chxrro/hackutd-26/hub/haptic_hub/sim/scenarios.py

"""The scenario library. Each scenario builds a fresh world, optionally injects
faults, and lists checks on what the belt does.

Geometry notes (default CameraModel, 60 deg horizontal FOV, 5 sectors): sector
boundaries sit at about -30, -19, -6.6, +6.6, +19, +30 deg from the camera axis.
With the default thresholds a static obstacle starts to buzz below ~2.27 m
z-depth (depth risk 0 at 2.5 m, deadband 0.12), and a tracked person starts to
buzz once the box-growth TTC drops under 3 s.

Tags:
  core   pipeline behavior that should hold today (gates the run)
  fault  failure injection: stale camera, disconnects, crashes, lost belt writes
  probe  known or suspected perception limitations; expected to fail today and
         reported as findings, not as regressions
"""

from __future__ import annotations

import math
from collections.abc import Callable
from dataclasses import dataclass, field

from haptic_hub.config import HubConfig
from haptic_hub.sim import checks as c
from haptic_hub.sim.oracle import OracleNoise
from haptic_hub.sim.render import CameraModel
from haptic_hub.sim.world import Box, Walker, World, const, person, pole, ramp, steps, wall

ALL = (0, 1, 2, 3, 4)


@dataclass(frozen=True)
class Fault:
    kind: str  # camera_freeze | phone_disconnect | garbage | latency | perception_crash |
    #            perception_stall | belt_drop | belt_unapplied | belt_disconnect | user_stop | user_stop_unpaired
    start: float
    end: float
    value: float = 0.0


@dataclass
class Scenario:
    name: str
    description: str
    duration: float
    build: Callable[[], World]
    checks: list[c.Check]
    faults: list[Fault] = field(default_factory=list)
    tags: frozenset[str] = frozenset({"core"})
    camera: CameraModel = field(default_factory=CameraModel)
    noise: OracleNoise | None = None
    configure: Callable[[HubConfig], None] | None = None
    fps: float = 15.0
    danger_m: float = 1.2  # for the informational coverage metric
    quiet_m: float = 3.0


def _pole_ahead(x: float = 0.0, y: float = 1.2) -> Callable[[], World]:
    return lambda: World([pole(x, y, radius=0.05)], Walker())


def _wall_ahead(walk_s: float, speed: float = 0.8, face_y: float = 4.525, **walker) -> Callable[[], World]:
    def build() -> World:
        return World([wall(-6, face_y + 0.075, 6, face_y + 0.075)], Walker(speed=steps((0, speed), (walk_s, 0)), **walker))

    return build


def _approaching_person(speed: float = 1.5, start_y: float = 9.0, stop_y: float = 1.9, x: float = 0.0,
                        confidence: float = 0.9, extra=()) -> Callable[[], World]:  # fmt: skip
    """Standing wearer; a person walks straight at them and stops at stop_y."""
    stop_t = (start_y - stop_y) / speed

    def build() -> World:
        p = person(x, start_y, velocity=(0, -speed), moving=steps((0, 1), (stop_t, 0)), confidence=confidence)
        return World([*extra, p], Walker())

    return build


def _careful_walker(threshold: int = 150, reaction_s: float = 0.4):
    """A crude model of a person using the belt: waits while it plays the fault
    pattern (including at start-up), and stops for good reaction_s after any of
    the three middle motors reaches `threshold`."""
    state: dict[str, float | None] = {"felt": None}

    def react(levels: tuple[int, ...], fault: bool, t: float) -> float:
        if fault:
            return 0.0
        if state["felt"] is None and max(levels[1:4]) >= threshold:
            state["felt"] = t
        felt = state["felt"]
        return 0.0 if felt is not None and t - felt >= reaction_s else 1.0

    return react


def _scenarios() -> list[Scenario]:
    deg = math.radians
    s: list[Scenario] = []

    # ------------------------------------------------------------ core behavior
    s.append(Scenario(
        "approach_wall", "Walk at 0.8 m/s toward a wide wall and stop ~0.9 m short.", 6.5,
        _wall_ahead(walk_s=4.5),
        [c.motors_off(ALL, 0.8, 2.3), c.motors_on(ALL, 3.4, 6.5), c.level_rises(2, (3.0, 3.6), (5.0, 6.5)),
         c.no_fault(0.8, 6.5), c.no_collision(), c.status_reports(1.0, 6.5, healthy=True)],
    ))  # fmt: skip
    s.append(Scenario(
        "pole_left", "Standing; a thin pole 1.2 m ahead, 0.55 m to the left.", 4.0,
        _pole_ahead(-0.55), [c.motors_on(0, 1.0, 4.0), c.motors_off((1, 2, 3, 4), 1.0, 4.0), c.no_fault(0.8, 4.0)],
    ))  # fmt: skip
    s.append(Scenario(
        "pole_right", "Standing; a thin pole 1.2 m ahead, 0.55 m to the right.", 4.0,
        _pole_ahead(0.55), [c.motors_on(4, 1.0, 4.0), c.motors_off((0, 1, 2, 3), 1.0, 4.0), c.no_fault(0.8, 4.0)],
    ))  # fmt: skip
    s.append(Scenario(
        "two_poles", "Poles left and right with a clear gap in the middle.", 4.0,
        lambda: World([pole(-0.55, 1.2, radius=0.05), pole(0.55, 1.2, radius=0.05)], Walker()),
        [c.motors_on((0, 4), 1.0, 4.0), c.motors_off((1, 2, 3), 1.0, 4.0)],
    ))  # fmt: skip
    s.append(Scenario(
        "pole_center", "Standing; a thin pole 1.2 m straight ahead.", 4.0,
        _pole_ahead(0.0), [c.motors_on(2, 1.0, 4.0), c.motors_off((0, 1, 3, 4), 1.0, 4.0), c.no_fault(0.8, 4.0)],
    ))  # fmt: skip
    s.append(Scenario(
        "three_obstacles", "Pole left at 1.2 m, wall segment center-right at 1.6 m, nothing far right.", 4.0,
        lambda: World([pole(-0.55, 1.2, radius=0.05), wall(-0.05, 1.6, 0.35, 1.6, thickness=0.1)], Walker()),
        [c.motors_on((0, 2, 3), 1.0, 4.0), c.motors_off((1, 4), 1.0, 4.0), c.strongest(0, 1.0, 4.0)],
    ))  # fmt: skip
    s.append(Scenario(
        "person_vs_pole", "Standing; a still pole 3 m ahead-right (outside the depth range) and a person "
        "walking in at 1.5 m/s ahead-left who stops 2.6 m away. Only the approaching person should buzz, "
        "and only while approaching.", 6.0,
        _approaching_person(start_y=7.5, stop_y=2.6, x=-0.5, extra=(pole(0.5, 3.0, radius=0.05),)),
        [c.motors_off(ALL, 1.0, 2.2), c.motors_on(1, 2.85, 3.35, min_frac=0.7), c.motors_off((3, 4), 1.0, 6.0),
         c.motors_off(ALL, 4.6, 6.0), c.no_fault(0.8, 6.0)],
    ))  # fmt: skip
    s.append(Scenario(
        "camera_motion", "Standing; a still person 4 m ahead and a pole 3.5 m ahead-right. The head sways "
        "+-10 deg (yaw, 1.2 Hz) and bobs +-5 deg (pitch, 2.4 Hz). Nothing is close or approaching.", 5.0,
        lambda: World([person(0, 4.0), pole(0.6, 3.5)],
                      Walker(head_yaw=lambda t: deg(10) * math.sin(2 * math.pi * 1.2 * t),
                             pitch=lambda t: deg(5) * math.sin(2 * math.pi * 2.4 * t))),
        [c.motors_off(ALL, 1.0, 5.0), c.no_fault(0.8, 5.0)],
    ))  # fmt: skip
    s.append(Scenario(
        "walking_sway", "Walk 0.8 m/s toward a wall with +-8 deg head sway; the wall must still alert.", 6.5,
        _wall_ahead(walk_s=4.5, head_yaw=lambda t: deg(8) * math.sin(2 * math.pi * 1.0 * t)),
        [c.motors_on((1, 2, 3), 4.0, 6.5), c.no_fault(0.8, 6.5), c.no_collision()],
    ))  # fmt: skip
    s.append(Scenario(
        "low_confidence_person", "person_approaching, but the detector only scores the person 0.2 (below "
        "detector_conf 0.35, e.g. poor light). Depth must still alert once the person is in range.", 6.0,
        _approaching_person(confidence=0.2),
        [c.motors_off(ALL, 1.0, 4.1), c.motors_on(2, 4.6, 6.0), c.no_fault(0.8, 6.0)],
    ))  # fmt: skip
    s.append(Scenario(
        "head_turn", "Pole straight ahead of the torso; at 2.5 s the wearer looks 25 deg left. "
        "The alert follows the head (documented behavior), so it moves to the right motor.", 5.0,
        lambda: World([pole(0, 1.5, radius=0.05)], Walker(head_yaw=ramp(2.5, 2.8, 0.0, deg(-25)))),
        [c.motors_on(2, 1.0, 2.4), c.motors_off((0, 1, 3, 4), 1.0, 2.4),
         c.motors_on(4, 3.2, 5.0), c.motors_off((0, 1, 2), 3.2, 5.0)],
    ))  # fmt: skip
    s.append(Scenario(
        "person_approaching", "Standing; a person walks at the wearer at 1.5 m/s from 9 m and stops 1.9 m "
        "away. Box-growth TTC must alert before depth range (~2.27 m, from t~4.3 s).", 6.0,
        _approaching_person(),
        [c.motors_off(ALL, 1.0, 3.2), c.motors_on(2, 3.85, 4.3, min_frac=0.8), c.motors_on(2, 4.4, 6.0),
         c.no_fault(0.8, 6.0)],
        danger_m=1.8,
    ))  # fmt: skip
    s.append(Scenario(
        "clear_path", "Walk 1 m/s down an open path lined with poles 3.5 m to each side.", 5.0,
        lambda: World([pole(x, y) for y in range(2, 20, 3) for x in (-3.5, 3.5)] + [wall(-10, 30, 10, 30)],
                      Walker(speed=const(1.0))),
        [c.motors_off(ALL, 1.0, 5.0), c.no_fault(0.8, 5.0), c.no_collision()],
    ))  # fmt: skip
    s.append(Scenario(
        "careful_walker", "Closed loop: the wearer walks at 1.2 m/s toward a wall and stops 0.4 s after a middle "
        "motor reaches level 150.", 7.0,
        lambda: World([wall(-6, 6.6, 6, 6.6)], Walker(speed=const(1.2), react=_careful_walker())),
        [c.no_collision(), c.clearance_at_end(0.3, 1.6), c.motors_on(2, 6.0, 7.0)],
    ))  # fmt: skip
    s.append(Scenario(
        "noisy_depth", "approach_wall with a depth model that reads 15% far and has 10% per-pixel noise.", 6.5,
        _wall_ahead(walk_s=4.5), [c.motors_on(ALL, 4.5, 6.5), c.no_fault(0.8, 6.5), c.no_collision()],
        noise=OracleNoise(depth_scale=1.15, depth_sigma=0.10),
    ))  # fmt: skip
    s.append(Scenario(
        "flaky_detector", "person_approaching with a detector that misses the person on 30% of frames.", 6.0,
        _approaching_person(),
        [c.motors_off(ALL, 1.0, 3.2), c.motors_on(2, 4.4, 6.0, min_frac=0.85), c.no_fault(0.8, 6.0)],
        noise=OracleNoise(miss_prob=0.3),
    ))  # fmt: skip

    # ------------------------------------------------------------ failure injection
    fault = frozenset({"fault"})
    stale = HubConfig().safety.frame_stale_s
    belt_period = 1 / HubConfig().haptics.send_hz
    s.append(Scenario(
        "camera_freeze", "Pole ahead; the glasses stream stalls for 2 s (phone still connected).", 6.5,
        _pole_ahead(),
        [c.motors_on(2, 1.0, 2.4), c.fault_within(2.5, stale + belt_period + 0.15), c.fault_during(3.7, 4.5),
         c.recovers_within(4.5, 0.6), c.motors_on(2, 5.3, 6.5), c.status_reports(3.8, 4.5, healthy=False)],
        [Fault("camera_freeze", 2.5, 4.5)], fault,
    ))  # fmt: skip
    s.append(Scenario(
        "phone_disconnect", "Pole ahead; the phone's WebSocket drops for 2 s, then reconnects.", 6.5,
        _pole_ahead(),
        [c.motors_on(2, 1.0, 2.4), c.fault_within(2.5, stale + belt_period + 0.15), c.fault_during(3.7, 4.5),
         c.recovers_within(4.5, 0.8), c.motors_on(2, 5.5, 6.5), c.counter("phone_connects", lambda n: n >= 2, ">= 2")],
        [Fault("phone_disconnect", 2.5, 4.5)], fault,
    ))  # fmt: skip
    s.append(Scenario(
        "perception_crash", "Pole ahead; the model raises on every frame for 1.5 s.", 5.5,
        _pole_ahead(),
        [c.motors_on(2, 1.0, 2.4), c.fault_within(2.5, 0.3), c.fault_during(2.9, 4.0), c.recovers_within(4.0, 0.6),
         c.motors_on(2, 4.8, 5.5), c.status_reports(2.9, 4.0, healthy=False)],
        [Fault("perception_crash", 2.5, 4.0)], fault,
    ))  # fmt: skip
    result_stale = HubConfig().safety.result_stale_s
    s.append(Scenario(
        "perception_stall", "Pole ahead; one inference hangs for 2.5 s (frames keep arriving).", 6.5,
        _pole_ahead(),
        [c.motors_on(2, 1.0, 2.4), c.fault_within(2.5, result_stale + 0.3), c.recovers_within(5.0, 0.6),
         c.motors_on(2, 5.8, 6.5)],
        [Fault("perception_stall", 2.5, 2.6, value=2.5)], fault,
    ))  # fmt: skip
    # Lost writes: the hub writes with response, so it notices within one command
    # TTL (+ a belt-loop tick, + one status period for the phone to hear it), sends
    # the fault pattern, and after BleBelt.WRITE_TIMEOUT_S without an answer drops
    # the connection and reconnects.
    ttl_s = HubConfig().haptics.ttl_ms / 1000
    status_period = 1 / HubConfig().status_hz
    s.append(Scenario(
        "belt_writes_lost", "Pole ahead; BLE writes are silently lost for 1 s (link stays up). The firmware TTL "
        "plays the fault pattern; the hub must report 'belt not acknowledging', reconnect, and recover.", 5.5,
        _pole_ahead(),
        [c.motors_on(2, 1.0, 2.4), c.fault_within(2.5, ttl_s + belt_period + 0.05), c.fault_during(2.9, 3.5),
         c.status_unhealthy_within(2.5, ttl_s + belt_period + status_period + 0.15, "belt not acknowledging"),
         c.status_reports(2.5 + ttl_s + belt_period + status_period + 0.15, 3.5, healthy=False, min_frac=1.0),
         c.recovers_within(3.5, 0.6), c.motors_on(2, 4.3, 5.5), c.status_reports(4.5, 5.5, healthy=True, min_frac=1.0),
         c.counter("belt_reconnects", lambda n: n >= 1, ">= 1")],
        [Fault("belt_drop", 2.5, 3.5)], fault,
    ))  # fmt: skip
    # Writes acknowledged but never applied: the write-ack check can't see this.
    # The firmware's TTL lapses, its status notification (sent on the mode change)
    # says "expired", and the hub reports it within one TTL + notify latency + a
    # belt-loop tick + one status period. No reconnect: the link itself is fine.
    s.append(Scenario(
        "belt_not_applying", "Pole ahead; for 1 s the belt's BLE stack acknowledges every write but the firmware "
        "never applies them (event queue full / main loop stalled). The firmware TTL plays the fault pattern; "
        "only its status notifications show it. The hub must report 'belt TTL expired' and recover.", 5.5,
        _pole_ahead(),
        [c.motors_on(2, 1.0, 2.4), c.fault_within(2.5, ttl_s + belt_period + 0.05), c.fault_during(2.9, 3.5),
         c.status_unhealthy_within(2.5, ttl_s + belt_period + status_period + 0.15, "belt TTL expired"),
         c.status_reports(2.5 + ttl_s + belt_period + status_period + 0.15, 3.5, healthy=False, min_frac=1.0),
         c.recovers_within(3.5, 0.6), c.motors_on(2, 4.3, 5.5), c.status_reports(4.5, 5.5, healthy=True, min_frac=1.0),
         c.counter("belt_writes_unapplied", lambda n: n >= 10, ">= 10"),
         c.counter("belt_reconnects", lambda n: n == 0, "== 0")],
        [Fault("belt_unapplied", 2.5, 3.5)], fault,
    ))  # fmt: skip
    s.append(Scenario(
        "belt_disconnect", "Pole ahead; the BLE link drops for 1 s; the hub reconnects.", 5.5,
        _pole_ahead(),
        [c.motors_on(2, 1.0, 2.4), c.fault_within(2.5, 0.05), c.fault_during(2.6, 3.5),
         c.status_unhealthy_within(2.5, belt_period + status_period + 0.1),
         c.status_reports(2.5 + belt_period + status_period + 0.1, 3.5, healthy=False, min_frac=1.0),
         c.recovers_within(3.5, 0.8), c.motors_on(2, 4.5, 5.5), c.status_reports(4.7, 5.5, healthy=True, min_frac=1.0)],
        [Fault("belt_disconnect", 2.5, 3.5)], fault,
    ))  # fmt: skip
    # The wearer's Stop vs. a phone that just goes away (docs/protocol.md "end_session").
    s.append(Scenario(
        "user_stop", "Pole ahead; at 2.5 s the wearer presses Stop (paired phone: end_session, then the camera "
        "stops). The belt plays the session-ended cue and stays quiet, also while the phone's Wi-Fi drops "
        "(4.0-4.8 s). Start at 5.5 s brings alerts back.", 8.0,
        _pole_ahead(),
        [c.motors_on(2, 1.0, 2.4), c.no_fault(2.5, 5.5), c.pulses((1, 3), 2.6, 4.3, count=3),
         c.motors_off(ALL, 4.3, 5.5), c.status_reason(2.8, 5.4, "stopped by wearer"),
         c.hub_reason(2.8, 5.4, "stopped by wearer"), c.motors_on(2, 6.6, 8.0), c.status_reports(7.0, 8.0, healthy=True),
         c.counter("end_session_ok", lambda n: n == 1, "== 1"), c.counter("phone_connects", lambda n: n >= 2, ">= 2")],
        [Fault("user_stop", 2.5, 5.5), Fault("phone_disconnect", 4.0, 4.8)], fault,
    ))  # fmt: skip
    s.append(Scenario(
        "phone_vanishes", "Pole ahead; at 2.5 s the phone vanishes (WebSocket gone, no end_session) and never "
        "comes back. The hub must play the fault pattern for as long as it runs.", 5.5,
        _pole_ahead(),
        [c.motors_on(2, 1.0, 2.4), c.fault_within(2.5, stale + belt_period + 0.15), c.fault_during(3.7, 5.5),
         c.hub_reason(3.7, 5.5, "no camera frames"), c.counter("phone_connects", lambda n: n == 1, "== 1")],
        [Fault("phone_disconnect", 2.5, 99.0)], fault,
    ))  # fmt: skip
    s.append(Scenario(
        "user_stop_unpaired", "Pole ahead; a phone without the control code presses Stop at 2.5 s. end_session "
        "is refused (not paired), so the hub treats it like a lost phone: fault pattern.", 5.0,
        _pole_ahead(),
        [c.motors_on(2, 1.0, 2.4), c.fault_within(2.5, stale + belt_period + 0.15), c.fault_during(3.7, 5.0),
         c.hub_reason(3.7, 5.0, "no camera frames"), c.counter("end_session_refused", lambda n: n == 1, "== 1")],
        [Fault("user_stop_unpaired", 2.5, 99.0)], fault,
    ))  # fmt: skip
    s.append(Scenario(
        "garbage_frames", "Pole ahead; the phone interleaves malformed packets and broken JPEGs.", 5.0,
        _pole_ahead(),
        [c.no_fault(0.8, 5.0), c.motors_on(2, 1.0, 5.0), c.counter("bad_messages", lambda n: n >= 10, ">= 10")],
        [Fault("garbage", 0.5, 5.0, value=2)], fault,
    ))  # fmt: skip
    s.append(Scenario(
        "network_latency", "approach_wall with 200 +-100 ms phone->hub latency.", 6.5,
        _wall_ahead(walk_s=4.5),
        [c.no_fault(0.8, 6.5), c.motors_on(ALL, 4.2, 6.5), c.no_collision()],
        [Fault("latency", 0.0, 6.5, value=0.2)], fault,
    ))  # fmt: skip

    # ------------------------------------------------------------ probes (limitations)
    probe = frozenset({"probe"})
    s.append(Scenario(
        "probe_indoor_ceiling", "Standing in the middle of an 8 x 12 m room with a 2.6 m ceiling; nearest wall "
        "is 6 m ahead. Should be quiet.", 4.0,
        lambda: World([wall(-4, 6, 4, 6), wall(-4, -6, 4, -6), wall(-4, -6, -4, 6), wall(4, -6, 4, 6)],
                      Walker(), ceiling=2.6),
        [c.motors_off(ALL, 1.0, 4.0)], tags=probe,
    ))  # fmt: skip
    s.append(Scenario(
        "probe_looking_down", "Open ground, nothing within 10 m, head pitched 20 deg down (a normal walking "
        "posture). Should be quiet.", 4.0,
        lambda: World([wall(-10, 15, 10, 15)], Walker(pitch=const(deg(20)))),
        [c.motors_off(ALL, 1.0, 4.0)], tags=probe,
    ))  # fmt: skip
    s.append(Scenario(
        "probe_low_obstacle", "Walk at 0.8 m/s toward a 0.45 m tall box (bench / bin height) 3 m ahead.", 5.5,
        lambda: World([Box(0.45, (40, 140, 200), center=(0, 3.3), size=(1.2, 0.6), name="low box")],
                      Walker(speed=const(0.8))),
        [c.motors_on(2, 2.6, 3.4, min_frac=0.5), c.no_collision()], tags=probe,
    ))  # fmt: skip
    s.append(Scenario(
        "probe_low_confidence_warning", "low_confidence_person, asking for the early (TTC) warning that a "
        "confident detection gives at 3.85-4.3 s. Low-confidence boxes are dropped, so nothing marks the "
        "person as uncertain: is the wearer told anything before depth range?", 6.0,
        _approaching_person(confidence=0.2),
        [c.motors_on(2, 3.85, 4.3, min_frac=0.5)], tags=probe,
    ))  # fmt: skip
    s.append(Scenario(
        "probe_ttc_lag", "Person walks in at 1.2 m/s from 8 m. Ask for an alert by the time the true TTC "
        "(center distance / speed) is 2.5 s (t~4.2 s), i.e. that the box-growth TTC isn't late.", 6.0,
        _approaching_person(speed=1.2, start_y=8.0),
        [c.motors_on(2, 4.2, 4.5, min_frac=0.9)], tags=probe,
    ))  # fmt: skip
    s.append(Scenario(
        "probe_jittery_boxes", "Standing; a person walks in at 1.5 m/s from 9 m, detector boxes jitter 4 px "
        "(sigma, full-res). Should stay quiet while the person is far (> 4.5 m) and not yet near TTC 3 s.", 6.0,
        _approaching_person(), [c.motors_off(ALL, 1.0, 3.0)], tags=probe,
        noise=OracleNoise(box_jitter_px=4.0),
    ))  # fmt: skip
    return s


SCENARIOS: dict[str, Scenario] = {sc.name: sc for sc in _scenarios()}


def select(names: list[str] | None, tags: set[str] | None = None) -> list[Scenario]:
    if names:
        unknown = [n for n in names if n not in SCENARIOS]
        if unknown:
            raise KeyError(f"unknown scenario(s) {unknown}; known: {sorted(SCENARIOS)}")
        return [SCENARIOS[n] for n in names]
    return [sc for sc in SCENARIOS.values() if tags is None or sc.tags & tags]
