chxrro/hackutd-26/(commit log)

2026-11-07 docs: record HackUTD project context and open decisions
    Document project context, goals, and initial milestones for HackUTD 2026 accessibility prototype.
2026-11-07 docs: add agent guide for HackUTD prototype
    Added a comprehensive agent guide outlining project context, working rules, safety design, and validation processes for the HackUTD 2026 accessibility project.
2026-11-07 docs: link project context from README
    Added project context and description for accessibility prototype.
2026-11-07 docs: add wire protocol shared by esp32, hub and meta
2026-11-07 esp32: BLE belt firmware with TTL failsafe, fault pattern and serial console
    [ble_link.cpp, ble_link.h, config.h, main.cpp, motors.cpp, motors.h, test_main.cpp]
2026-11-07 hub: video feed in, depth + YOLO collision perception, haptic commands out over BLE
    [__main__.py, app.py, cli.py, config.py]
2026-11-07 meta: iPhone app that streams the Meta glasses camera to the hub
2026-11-08 Add standalone Ray-Ban Camera Bridge diagnostic
2026-11-08 hub: person vs object labels, local and Nemotron cloud backend
    Every tracked box gets a person/object label (--classifier local|nim).
    local reuses YOLO's COCO class. nim asks Nemotron 3 Nano Omni behind any
    OpenAI-compatible endpoint (vLLM on Brev, or build.nvidia.com) in the
    background at <=2 req/s, cached per track ID; YOLO stays the fast path.
    If boxes wait 3 s without a cloud reply, perception raises
    ClassifierUnavailable and the belt plays the fault pattern.
    Adds nim-bench to measure round trips. No new dependencies; protocol,
    belt behaviour and existing perception code unchanged.
2026-11-08 hub: fault when the perception result is too old
    The safety monitor only checked when the last result finished, not how old
    its frame was. A slow model (e.g. 1.4 s per frame) delivered results just
    under result_stale_s, so the belt played LEVELS or OFF from data up to 2.8 s
    old while reporting healthy, and an old result was replayed for a moment
    after a short frame gap.
    SafetyMonitor.perception_ok now takes the frame's receive time (hub
    monotonic clock) and check() faults when it is older than the new
    SafetyConfig.result_max_age_s (1.0 s, unvalidated starting value).
    [app.py, config.py, safety.py]
2026-11-08 hub: cloud classifier outage falls back to local labels, not the fault pattern
    A cloud outage (timeout, 429, network) made ClassifiedPerception raise
    ClassifierUnavailable, which discarded the whole result: the belt played the
    fault pattern instead of real depth/TTC alerts, although labels don't drive
    the belt. Now every box keeps its local label and debug["classifier"] carries
    stale=True and the reason, which the --show window prints as ERR.
    ClassifierUnavailable stays defined for when labels drive the belt; then an
    unavailable classifier has to become a fault again. Decision recorded in
    docs/project-context.md.
2026-11-08 hub: drop half-open BLE connections and keep reconnecting
    If connect() succeeded but reading the info characteristic failed, the
    client was never disconnected. The belt firmware stops advertising while
    connected, so the hub could never find it again; the belt heard nothing and
    went from the fault pattern to silence after 30 s. A short info payload
    raised ValueError, which killed the belt task and the hub.
    Setup failures now disconnect the client (5 s timeout), a short info payload
    is a BleakError, and run() retries after any exception. Reconnect delays are
    class attributes so tests can shorten them. Tested with a fake bleak client
    only.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
2026-11-08 hub: open-vocabulary detector option (--detector openvocab)
    Adds OpenVocabTracker (YOLOE, text prompts + ByteTrack) with the same
    track() interface as ObjectTracker, selected via PerceptionConfig.detector
    or --detector/--prompts. Labels map person-like prompts to "person" so
    classify.py keeps working. Default stays "yolo". vision.py/models.py
    unchanged. New vision dependency: clip (ultralytics fork, pinned commit).
2026-11-08 hub: opt-in session recording/replay and per-stage latency
    - --record wraps any frame source; JPEG + frames.jsonl per numbered session
    under hub/recordings/ (git-ignored), bounded by time/frames, written off the
    event loop, drops recorded copies instead of blocking.
    - --source replay:DIR replays a session at original timing, labelled replay.
    - Per-stage hub latency (queue, infer, to belt, hub total, drops, fps) logged
    every 5 s and shown in --show; phone status JSON unchanged.
2026-11-08 hub: add optional optical-flow approach/crossing risk (--motion flow)
    Adapts Nathan's optical-flow motion check from PR #3 (scripts/visual_motion.py)
    as a hub perception wrapper, off by default. For each ByteTrack box it fits a
    similarity transform to LK flow against a ~0.15 s older frame:
    - approach: TTC ~= dt / ln(scale), through the existing 1-3 s risk curve
    - crossing: box motion minus background motion (head turns cancel); a near box
    whose 1 s projection sweeps into the middle band raises the swept sectors to 0.5
    Flow only raises sector risk (max-merge); missing texture/reference adds
    nothing; failures raise so the belt plays the fault pattern. All thresholds
    live in FlowConfig and a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
    [cli.py, config.py, flow.py]
2026-11-08 meta: device-ready Info.plist, glasses app update button, test-day checklist
    - Info.plist: add external-accessory background mode and
    UISupportedExternalAccessoryProtocols (com.meta.ar.wearable), matching
    ios/Info.plist that ran on the iPhone 17; opt out of SDK crash reporting.
    - GlassesController/ContentView: "Update glasses app in Meta AI" button
    (openDATGlassesAppUpdate) for the "app component requires an update" error.
    - Hub section hint mentions hotspot and what a timeout means.
    - README: test-day checklist (build/install, hub, app steps, fault vs
    levels, network fallbacks, safety).
2026-11-08 docs: draft additive phone/dashboard -> hub control messages
    Pairing via a hub-generated control code in hello, control/ack messages
    (pause, resume, belt_test, set classifier/alert_range/record) and optional
    status fields. Frame, belt command and existing status fields unchanged.
2026-11-08 docs: clarify control protocol (get action, pairing scope, pause vs fault)
    Additive edits to the draft Control section, found while implementing the hub
    side:
    - new `get` action: no effect, returns settings, doubles as a pairing check
    - pairing is per connection; re-send hello after reconnect; wrong code unpairs
    - while paused, a real fault replaces "alerts paused" in `reason`; read `paused`
    - belt test status (levels, healthy:false, reason "belt test") and refusals
    - record: hubs without recording refuse true and accept false
    - ack `id` echoed as sent; only compare `error` with "not paired"
    - sectors[i].kind = largest box per direction; all null while faulted
    Frame packet, belt command and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
2026-11-08 docs: navigation guidance research and campus route build plan
    Add docs/navigation-research.md: prior work on haptic belts, heading
    sources, routing options and terms, indoor demo options, and the
    contract impact of belt guidance. Includes the ECSW -> Comets LANding
    campus demo build/test plan.
    Implementation is on hold until obstacle alerts work end to end in
    simulation. The `location` message and guidance status field are
    proposals only; docs/protocol.md is unchanged.
2026-11-08 hub: control layer and localhost operator dashboard
    - control.py: runtime settings (pause, belt_test, alert_range, classifier,
    record stub), pairing code, acks to the requesting client only, status
    additions (paused, settings, sectors[i].kind)
    - glasses.py: route hello/control to the control layer, redact control_code
    from logs, cap websockets logging at INFO so -v can't leak the code
    - app.py: belt loop applies pause/belt test; status gains the new fields
    - viz.py: pure render() shared by --show (pixel-identical) and the dashboard
    - dashboard/: --dashboard on 127.0.0.1:8780, plain HTML/CSS/JS, host and
    origin checks, throttled preview that drops frames instead of queueing
    - cli.py: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
    [app.py, cli.py, control.py, viz.py]
2026-11-08 ios: make Camera Bridge the wearer app: hub streaming, control, VoiceOver
    Overhauls Ethan Hur's Camera Bridge (3e8d956) into the user-facing app for
    the Ray-Ban glasses and the haptic belt. His glasses capture, the glasses-app
    update shortcut and the HTTP viewer path are kept; the viewer moves to
    Setup -> Advanced.
    - Hub transport (docs/protocol.md section 1 + Control): HB frame packets,
    hello with control_code (re-sent on every reconnect), phone_status, status
    and ack. Implements get/pause/resume/belt_test/set; paused is read from the
    paused field, never from reason; belt test and "recording not available"
    handled; only error == "not paired" is compared. HubClient, FramePacket and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
2026-11-08 docs: Camera Bridge setup for the hub, mock glasses and checks
2026-11-08 hub: simulated world with firmware-in-the-loop belt and end-to-end scenarios
    Adds hub/haptic_hub/sim (run with `python -m haptic_hub.sim`):
    - numpy ray-cast world rendering glasses frames (504x896, 15 fps) with exact
    ground-truth depth and boxes;
    - a fake phone that sends HB packets over the real WebSocket server;
    - oracle stand-ins for the depth model and detector, so VisionPerception's
    fusion and TTC code runs unchanged (real models optional);
    - the belt firmware's esp32/lib/belt_core logic compiled for the host and
    driven through the real wire encoding (TTL, fault pattern, link loss);
    - 24 gating scenarios plus limitation probes, checked on what the belt does,
    with invariants that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
2026-11-08 docs: record simulated-world status and probe findings
2026-11-08 hub: sim mirrors --motion flow, reports hub stage latency, fixes invariant race
    - `python -m haptic_hub.sim --motion flow` wraps the oracle in
    FlowMotionPerception, as build_perception does; reports name the chain.
    - Each report includes haptic_hub.latency stage timings for the scenario.
    - The fake phone stamps capture_ms before injected network delay, like meta/.
    - The silence invariant compares belt samples on both sides of the hub
    sample, so a health change at that instant isn't counted as a violation
    (a hub that sends OFF instead of FAULT is still caught).
    [__main__.py, checks.py, phone.py, runner.py]
2026-11-08 docs: record the 2026-11-07/08 integration round in project context
    Decisions (#5 stale-result fault, #9 flow motion, #11 open-vocab opt-in, #14
    Control protocol, #13 navigation on hold, #17 ios/ as the wearer app, single
    integration thread + CI) separated from proposals. Status table updated, with
    per-PR evidence and limits labelled unit tests / simulation / synthetic /
    hardware (nothing merged today was tested on hardware). Adds the synthetic TTC
    baseline with figures taken from the run output, correcting an earlier summary
    (0.38-0.63 s late, 0.33-0.53 s hang-over, early false alert on the far-left
    motor only, not from the bus box). Lists the open owner decisions: MobileCLIP2
    licence, meta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
2026-11-08 cad: parametric belt control-box enclosure (rush print version) (#10)
    Adds cad/belt-enclosure/: OpenSCAD source, build.sh (exports STL/3MF, runs interference checks) and README. Generated STLs are not committed (gitignored; regenerate with build.sh). Not printed or test-fitted; dimensions are photo estimates marked MEASURE.
    Squash-merged so the STLs from the branch's first commit stay out of main's history.
    [belt_enclosure.scad]
2026-11-08 hub: sim firmware build without -Werror (unknown CI compilers must not skip the sim)
    [firmware.py]
2026-11-08 hub: pause and resume play a belt cue instead of going silent
    Pause used to send `off`, so the wearer felt the same silence as "no
    obstacle", and a helper could pause from the dashboard or phone without
    the wearer knowing. A real fault while paused was also sent as `off`
    (only the status showed it).
    - pause: outside-in cue (outer pair, inner pair, centre; 0.6 s), then a
    low pulse on the outer motors every 15 s (--pause-reminder, 0 = off)
    - resume: inside-out cue (0.6 s, reason "resuming alerts"), then normal
    - a camera/perception fault now plays the fault pattern while paused;
    the pause cue replays when the fault or a belt disconnect ends
    - cues are ordinary `levels` commands at the nor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
2026-11-08 docs: optional frame_source on phone_status and status (additive)
    Lets the hub tell real glasses frames from the iOS app's mock glasses and
    test pattern. Missing or unrecognized values mean "unknown", never
    "glasses". Frame format, belt command and existing fields unchanged.
2026-11-08 hub: track the phone's frame_source; label simulated/unknown input
    Stores what each phone connection declares in phone_status.frame_source,
    tags its frames, adds frame_source to the phone's status, logs each change
    once, labels anything but "glasses" SIMULATED/UNKNOWN on the dashboard,
    and writes it to recordings (frames.jsonl per frame, session.json counts).
    Missing or unrecognized values are "unknown". Belt output is unchanged.
    [app.py, record.py, types.py]
2026-11-08 hub: add `haptic-hub bench` hardware-day belt checks; docs: bring-up runbook
    hub/haptic_hub/bench/: connect (address, RSSI, connect time), motor map
    with y/n/r prompts, level ramp, TTL failsafe, fault pattern by command
    and by dropped link, reconnect, and BLE write timing (median/p90 of the
    write call, labelled as not motor latency). Optional --serial reads the
    belt's USB log to time TTL expiry and catch rejected commands/reboots.
    JSON report in hub/bench-reports/ (git-ignored), summary table, exit
    code 0/1/3/130. --belt sim runs the whole flow against SimBelt plus a
    model of the firmware TTL timing. cli.py change is additive (register
    subcommand, pass an exit code through).
    docs/hardware-b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
    [cli.py, flow.py, links.py, report.py, serial_log.py]
2026-11-08 ios: send frame_source (glasses | mock | test_pattern) in phone_status
    BridgeModel derives it from the run's source and the Debug mock-glasses
    switch; HubClient keeps it with the last phone_status and now re-sends that
    before marking a reconnect connected, so no frame overtakes it. Protocol
    tests cover the new phone_status example and wire values.
2026-11-08 hub: bench --belt sim runs against the real belt_core build
    Uses haptic_hub.sim.firmware (from #19) so the simulated TTL, link-lost
    and rejected-command events come from esp32/lib/belt_core, ticked every
    5 ms like main.cpp. Falls back to the Python TTL model, with a warning,
    when no C++ compiler is available.
2026-11-08 hub: report "belt not acknowledging" when BLE writes are lost
    The hub wrote belt commands without response, so silently lost writes left
    status healthy while the belt's TTL played the fault pattern. Commands now go
    out with write-with-response (the firmware already accepts both) through a
    latest-wins writer that never blocks the 15 Hz loop. No acknowledged write for
    longer than the command TTL -> healthy:false, reason "belt not acknowledging",
    and the fault pattern is sent; 3 acks in a row recover; an unanswered write
    (1 s) or 15 errors in a row drop the connection and reconnect.
    Belt link problems ("belt disconnected"/"belt connecting") now also make an
    unpaused hub unhealthy, and end a ru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
    [app.py, checks.py, control.py, firmware.py, runner.py]
2026-11-08 docs: belt write acknowledgement and belt status reasons
2026-11-08 ios: accurate wording for pause, reminder pulses and faults while paused
    Matches the hub's pause semantics (#20) and belt write health (#23):
    - Paused: "Alerts are off; the belt pulses softly every 15 seconds as a
    reminder." No more "the belt is off".
    - A real fault while paused is the headline and announcement, with the
    hub's fault-over-pause priority: "Warning: no camera frames (alerts
    paused)". Recovery while still paused: "Recovered. Still paused."
    - The ~0.6 s "resuming alerts" cue shows "Resuming alerts" and is not
    announced; the next state is announced once. Over 2 s it warns.
    - Belt disconnected/connecting are one kind whether reported in reason
    or the belt field, so a reco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
2026-11-08 docs: belt status characteristic (read + notify) and build id in info
    Shared contract change, additive. New BLE status characteristic
    (ba2928d9-...): firmware mode, last applied command seq and age, motor
    levels, uptime, build id, kMaxDuty; notifies on every mode change and at
    least every 500 ms. The info characteristic appends the build id text.
    Golden vectors for both. Section 2 gains belt status reasons and the
    optional belt_firmware / belt_confirmed status fields.
2026-11-08 esp32: status characteristic, build id, mode log
    - lib/belt_core/belt_status.*: status payload encoder and notify trigger
    (mode change or every 250 ms), host-testable; controller exposes the
    last applied command, link-lost cause and output levels.
    - ble_link: status characteristic (read + notify); info characteristic
    appends the build id text.
    - main: publishes status each loop when due; logs "[belt] mode -> X (seq N)"
    so a hub fault command shows on serial; boot line and `s` show build and
    max duty.
    - scripts/build_id.py: stamps the git commit into a generated header.
    - 6 new native tests (golden vector, modes, notify triggers).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
2026-11-08 hub: use the belt's status notifications for belt health
    - protocol: decode status and info (build id) per docs/protocol.md.
    - belt/confirm: StatusHealth checks the belt's reported mode and applied
    seq against what the hub wrote: "belt TTL expired", "belt playing fault
    pattern", "belt not applying commands", "belt status stale". The write
    ack reason keeps precedence.
    - belt/ble: subscribes when the GATT table has the status characteristic
    with notify; older firmware (or a failed subscription) falls back to
    write acknowledgements only.
    - status JSON: optional belt_firmware (build, mode, max duty, ...) and
    belt_confirmed ("status" | "ack" | null); dashboard shows them.
    - sim: the e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
    [app.py, belt_capi.cpp, firmware.py, protocol.py, runner.py]
2026-11-08 docs: end_session control action for a deliberate Stop
    Protocol (additive): paired-only control action `end_session`, a status
    reason "stopped by wearer", a `stopped` status field, and a session-ended
    belt cue. `phone_status` stream "starting" (or a new frame) ends the stop.
    A phone that goes away without end_session still gets the fault pattern.
    Records the decision in project-context and the app behaviour in
    camera-bridge.
2026-11-08 hub: tell a wearer's Stop apart from a lost phone (end_session)
    A paired end_session stops the session: the belt plays a session-ended cue
    (three fading pulses on the inner motors), then stays quiet; status is
    healthy:false, reason "stopped by wearer", stopped:true, and "no camera
    frames" no longer faults while stopped. Belt problems still outrank it.
    A frame received after the stop, or phone_status "starting" from any
    connection, starts a new session with the resume cue. Unpaired requests are
    refused, and a phone lost without end_session still faults.
    Sim: the fake phone gets Stop/Start like the app; new scenarios user_stop,
    phone_vanishes, user_stop_unpaired. The never-silent invariant ex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
    [app.py, checks.py, control.py, cues.py, phone.py, runner.py, scenarios.py]
2026-11-08 ios: Stop sends end_session before the camera stops
    Stop no longer pauses first: it sends end_session, then stops the camera.
    HubClient holds frames from end_session until the next "starting", so no
    frame follows the stop. The wearer screen says "Stopped. The belt will not
    alert." (spoken once; "Stopping" while the reply is pending is not spoken),
    warns when the hub wasn't told and will play the fault pattern, and warns if
    a later status says the hub is no longer stopped. Backgrounding never sends
    end_session.
2026-11-08 docs: bring-up runbook uses the belt status for ttl / fault-command
2026-11-08 hub: bench times TTL and checks fault commands from belt status
    When the firmware has the status characteristic, `haptic-hub bench`
    subscribes (BLE, or belt_core's own reports with --belt sim): `ttl` must
    see `mode -> expired` within the TTL + tolerance, `fault-command` must see
    `mode -> fault` within 500 ms (the feel stays operator-confirmed), and
    `connect` / `reconnect` record the build id and the mode after a drop.
    The serial reader also parses `[belt] mode -> X`. Older firmware falls
    back to the serial log as before.
    [flow.py, links.py, serial_log.py]
2026-11-08 esp32: add BLE ack and recovery handling
2026-11-08 meta: add belt BLE client, alert patterns, speech, phone haptics, frame rate limiter
2026-11-08 cad: add hex nut pockets for belt clip
    [belt_enclosure.scad]
2026-11-08 docs: update protocol and project context for belt ack/recovery
2026-11-09 docs: rewrite root README with photos, architecture, wiring, CAD and demo (#32)
    * docs: rewrite root README with photos, architecture, wiring, CAD and demo
    - New README: overview, system architecture, hub perception pipeline,
    perception demo, hardware (BOM, annotated photos, enclosure photo vs CAD,
    wiring and motor pin map, belt behavior), wire protocol, setup, measured
    results with evidence labels, limitations and safety.
    - docs/images: architecture and hub-pipeline diagrams, annotated belt
    photos, enclosure photo next to the OpenSCAD render, exploded CAD view,
    redrawn belt wiring diagram (same pin map as esp32/include/config.h).
    - docs/media: 10 s GIF excerpt and compressed 60 s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
2026-11-09 docs: restyle README figures and tighten README text (#33)
    - Figures redrawn in a plain engineering-drawing style: one typeface,
    thin black lines, square corners, and a single accent taken from the
    printed enclosure.
    - Architecture is now a topology diagram with numbered links that match
    the link table; the hub pipeline is simplified.
    - The wiring is now a schematic (U1–U3, C1, +5V and ground symbols, motor
    symbols on a shared +5V line). Pin map unchanged.
    - Photos are cropped to the belt, with one motor label per photo. The
    enclosure photo and CAD share numbered markers, and the CAD is
    re-rendered in the print color.
    - README: numbered figure captions, no slogan, badge row or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
